Scruchet/Touch-Switch/control_card/control_card.kicad_pcb

## KiCad design control_card/control_card.kicad_pcb (2024-06-04)

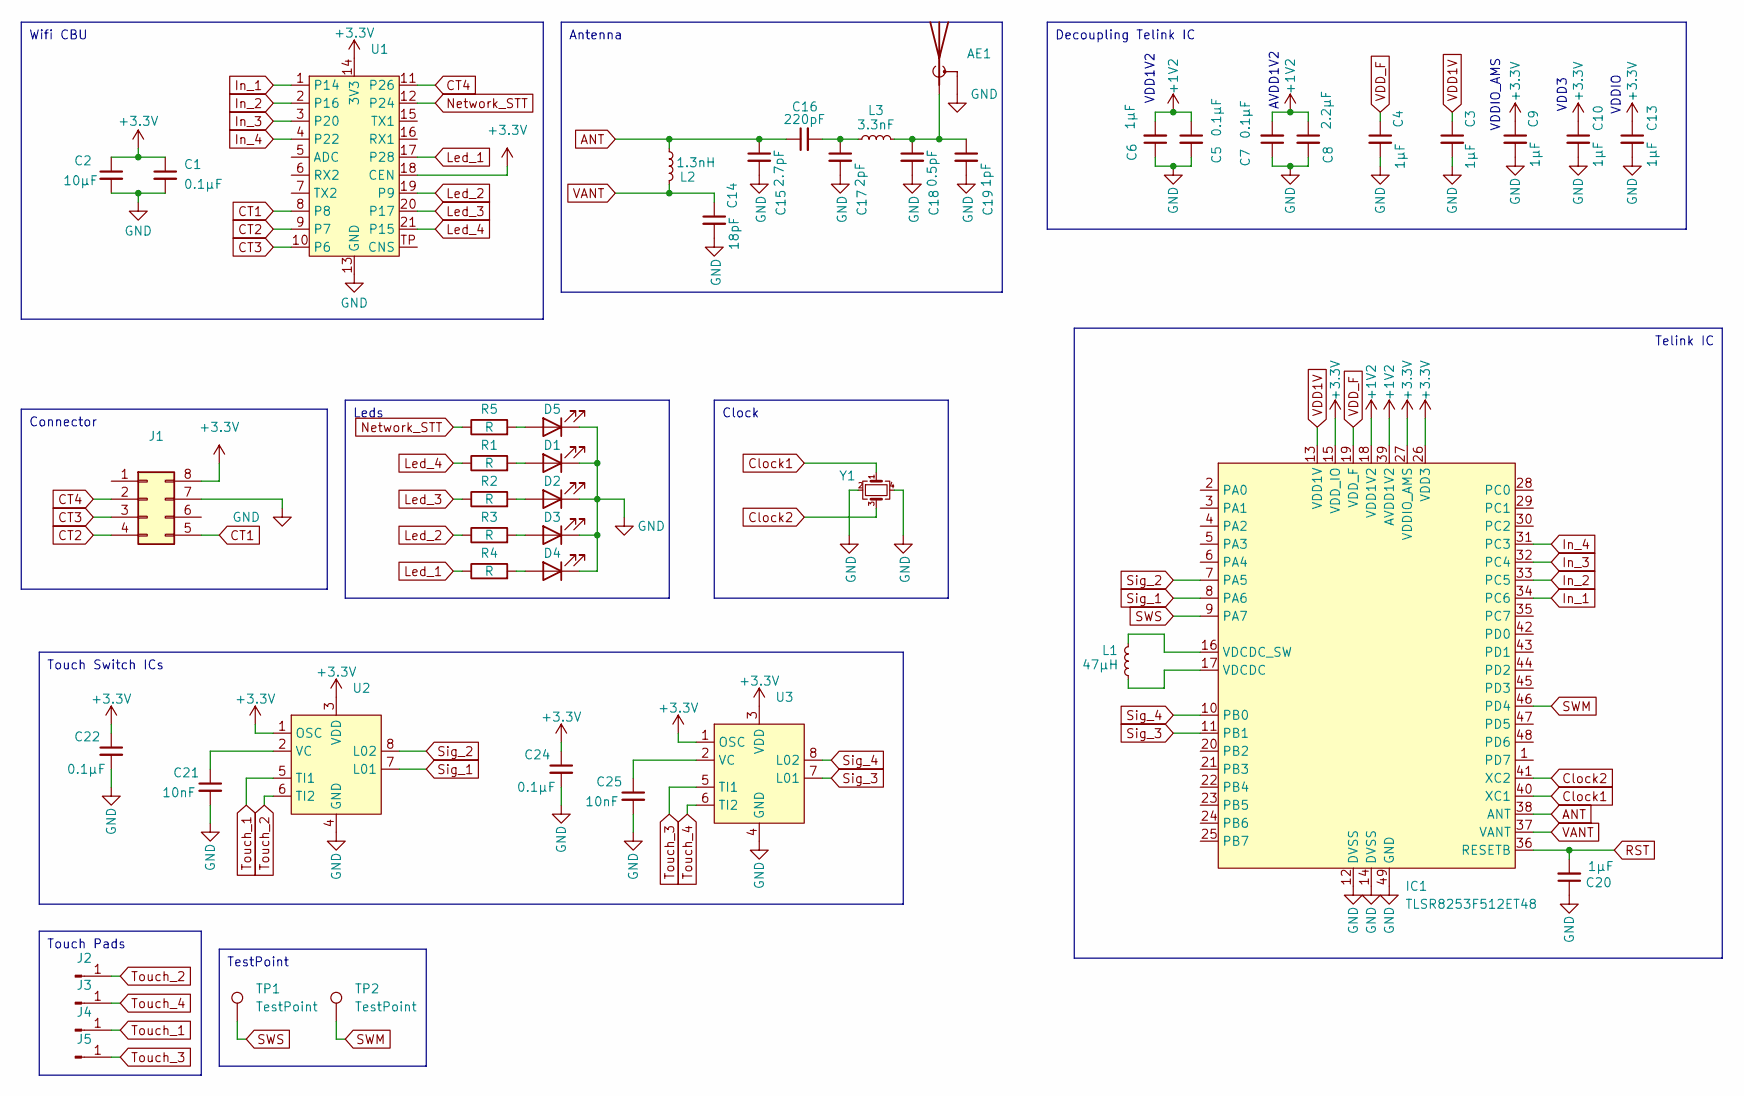
[picture p1: schematic control_card.kicad_sch]

Parts:
AE1: Antenna_Shield; Antenna
C1, C5, C7, C22, C24: 0.1µF; C_0603_1608Metric
C2: 10µF; C_0603_1608Metric
C3, C4, C6, C9, C10, C13, C20: 1µF; C_0603_1608Metric
C8: 2.2µF; C_0603_1608Metric
C14: 18pF; C_0603_1608Metric
C15: 2.7pF; C_0603_1608Metric
C16: 220pF; C_0603_1608Metric
C17: 2pF; C_0603_1608Metric
C18: 0.5pF; C_0603_1608Metric
C19: 1pF; C_0603_1608Metric
C21, C25: 10nF; C_0603_1608Metric
D1, D2, D3, D4, D5: LED; LED_0805_2012Metric
IC1: TLSR8253F512ET48; QFN-48-1EP_7x7mm_P0.5mm_EP5.6x5.6mm_ThermalVias; Mouser Part Number 141-TLSR8253F512ET32
J1: Conn_02x04_Counter_Clockwise; Male connector
J2, J3, J4, J5: Conn_01x01_Pin; Touch-Pad
L1: 47µH; L_0805_2012Metric
L2: 1.3nH; L_0402_1005Metric
L3: 3.3nF; L_0402_1005Metric
R1, R2, R3, R4, R5: R; R_0603_1608Metric
TP1, TP2: TestPoint; TestPoint_Pad_D1.0mm
U1: Wifi; Wifi CBU
U2, U3: SOIC-8_3.9x4.9mm_P1.27mm
Y1: Crystal_GND24_Small; Crystal_SMD_3225

Connections:
+1V2: C5.1, C6.2, C7.2, C8.1, IC1.18 (VDD1V2), IC1.39 (AVDD1V2)
+3.3V: C1.1, C2.1, C9.1, C10.1, C13.1, C22.1, C24.1, IC1.15 (VDD_IO), IC1.26 (VDD3), IC1.27 (VDDIO_AMS), J1.8, U1.14 (3V3), U1.18 (CEN), U2.1 (OSC), U2.3 (VDD), U3.1 (OSC), U3.3 (VDD)
ANT: C15.1, C16.1, IC1.38 (ANT), L2.1
CT1: J1.5, U1.8
CT2: J1.4, U1.9 (P7)
CT3: J1.3, U1.10 (P6)
CT4: J1.2, U1.11 (P26)
Clock1: IC1.40 (XC1), Y1.1
Clock2: IC1.41 (XC2), Y1.3
GND: AE1.2 (Shield), C1.2, C2.2, C3.2, C4.2, C5.2, C6.1, C7.1, C8.2, C9.2, C10.2, C13.2, C14.2, C15.2, C17.2, C18.2, C19.2, C20.1, C21.2, C22.2, C24.2, C25.2, D1.1 (K), D2.1 (K), D3.1 (K), D4.1 (K), D5.1 (K), IC1.12 (DVSS), IC1.14 (DVSS), IC1.49 (GND), J1.7, U1.13 (GND), U2.4 (GND), U3.4 (GND), Y1.2, Y1.4
In_1: IC1.34 (PC6), U1.1 (P14)
In_2: IC1.33 (PC5), U1.2 (P16)
In_3: IC1.32 (PC4), U1.3 (P20)
In_4: IC1.31 (PC3), U1.4 (P22)
Led_1: R4.1, U1.17 (P28)
Led_2: R3.1, U1.19 (P9)
Led_3: R2.1, U1.20 (P17)
Led_4: R1.1, U1.21 (P15)
unnamed: AE1.1 (A), C18.1, C19.1, L3.2
unnamed: C16.2, C17.1, L3.1
unnamed: D1.2 (A), R1.2
unnamed: D2.2 (A), R2.2
unnamed: D3.2 (A), R3.2
unnamed: D4.2 (A), R4.2
unnamed: D5.2 (A), R5.2
unnamed: IC1.17 (VDCDC), L1.1
unnamed: IC1.16 (VDCDC_SW), L1.2
unnamed: C21.1, U2.2 (VC)
unnamed: C25.1, U3.2 (VC)
Network_STT: R5.1, U1.12 (P24)
RST: C20.2, IC1.36 (RESETB)
SWM: IC1.46 (PD4), TP2.1; also elsewhere on the board
SWS: IC1.9 (PA7), TP1.1; also elsewhere on the board
Sig_1: IC1.8 (PA6), U2.7 (L01)
Sig_2: IC1.7 (PA5), U2.8 (L02)
Sig_3: IC1.11 (PB1), U3.7 (L01)
Sig_4: IC1.10 (PB0), U3.8 (L02)
Touch_1: J4.1, U2.5 (TI1)
Touch_2: J2.1, U2.6 (TI2)
Touch_3: J5.1, U3.5 (TI1)
Touch_4: J3.1, U3.6 (TI2)
VANT: C14.1, IC1.37 (VANT), L2.2
VDD1V: C3.1, IC1.13 (VDD1V)
VDD_F: C4.1, IC1.19 (VDD_F)

Notes on the sheet:
TestPoint
Antenna
Touch Switch ICs
Touch Pads
Leds
Wifi CBU
Connector
Clock
Decoupling Telink IC
Telink IC
AVDD1V2
VDD1V2
VDDIO
VDD3
VDDIO_AMS

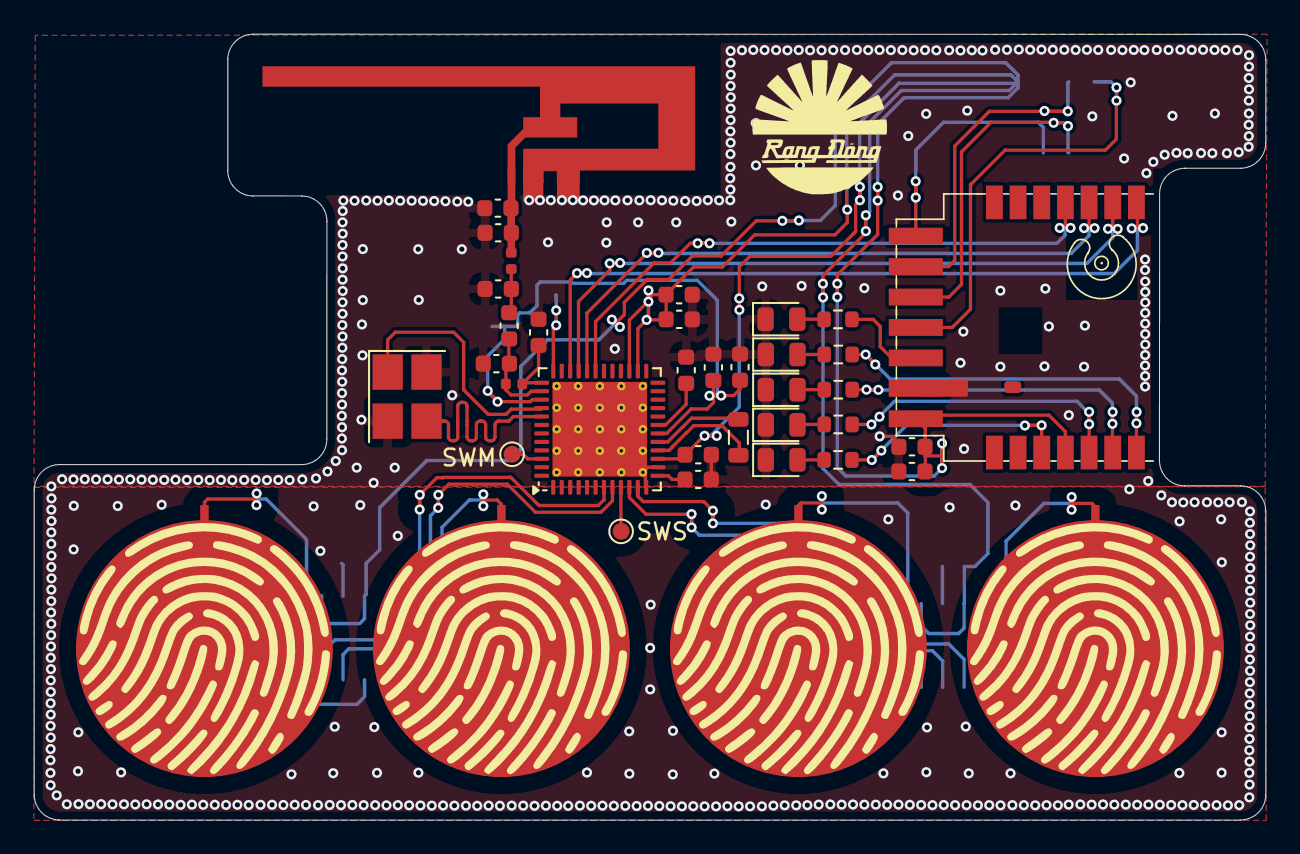
[picture p2: board control_card.kicad_pcb from above]

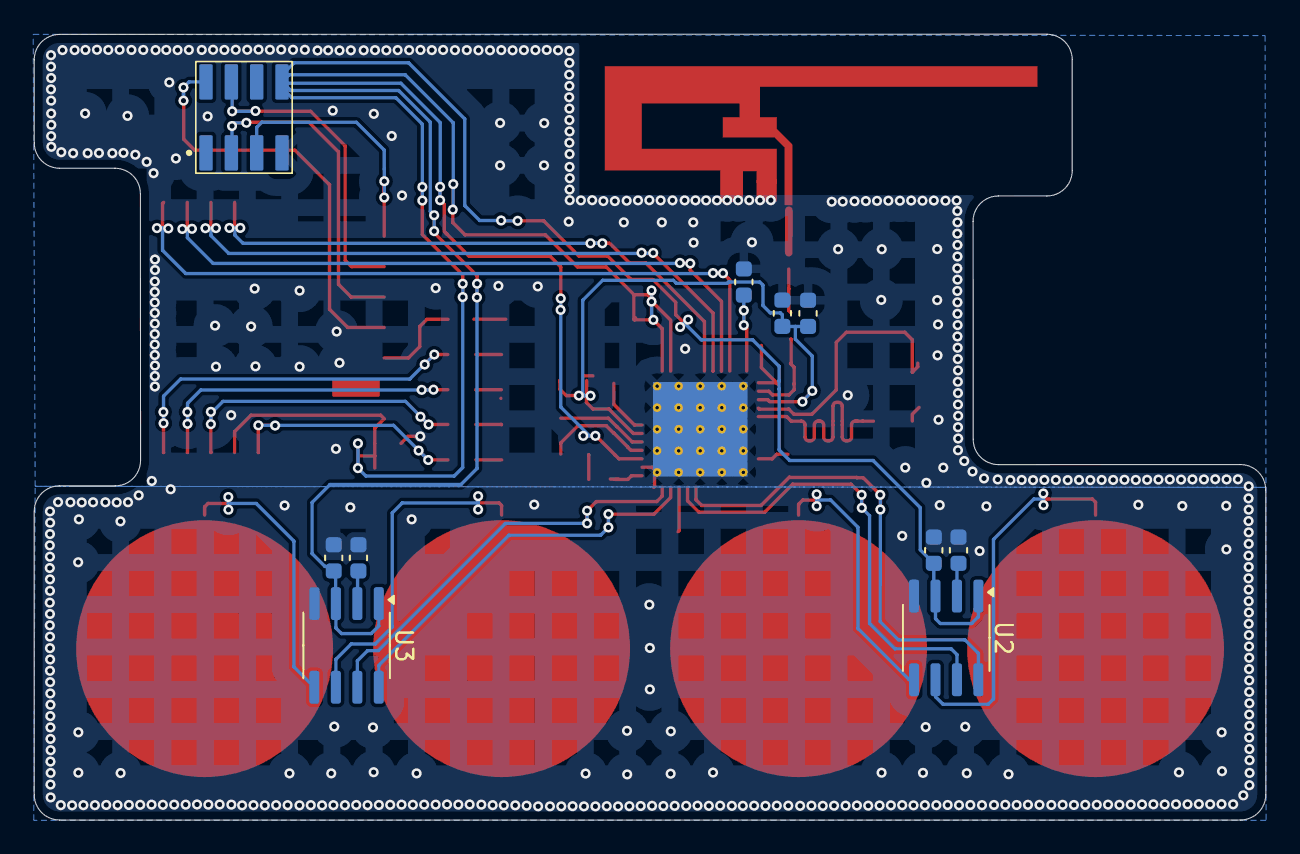
[picture p3: board control_card.kicad_pcb from below]

Board: 2 copper layers, 72.9 x 46.5 mm, 48 parts (10 on the bottom side), 44 nets.

Other parts of the board:
SWM: TestPoint; TestPoint_Pad_D1.0mm
SWS: TestPoint; TestPoint_Pad_D1.0mm

Their connections:
SWM: SWM.1; also elsewhere on the board
SWS: SWS.1; also elsewhere on the board
