Scruchet/Touch-Switch/power_supply/Touch Switch.kicad_pcb

## KiCad design power_supply/Touch Switch.kicad_pcb (2024-05-30)

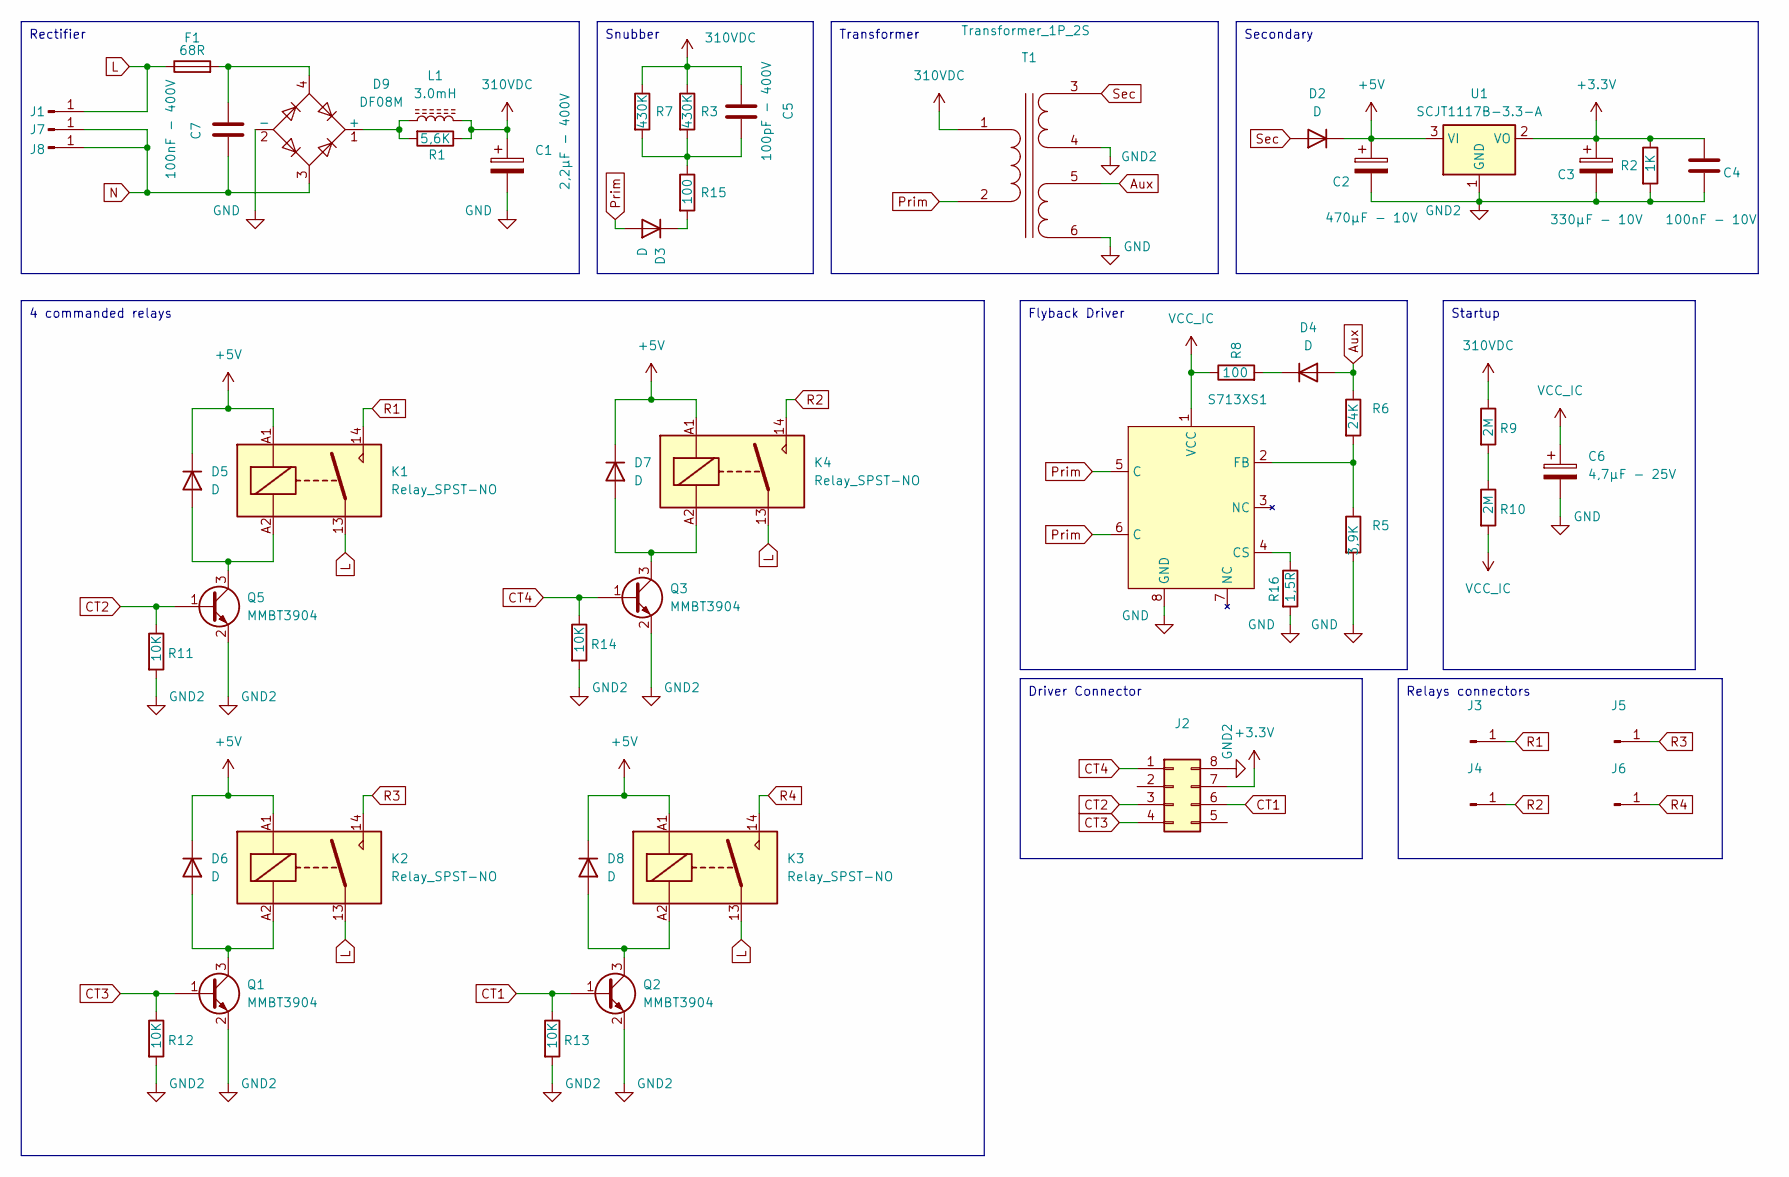
[picture p4: schematic Touch Switch.kicad_sch]

Parts:
C1: 2,2µF - 400V; CP_Radial_D8.0mm_P3.50mm
C2: 470µF - 10V; CP_Radial_D6.3mm_P2.50mm
C3: 330µF - 10V; CP_Radial_D6.3mm_P2.50mm
C4: 100nF - 10V; C_0805_2012Metric
C5: 100pF - 400V; C_1206_3216Metric
C6: 4,7µF - 25V; C_0805_2012Metric
C7: 100nF - 400V; MKP-X2-100NR10310
D2, D3, D4: D; D_SMA
D5, D6, D7, D8: D; D_SOD-123
D9: DF08M; Diode_Bridge_Diotec_ABS
F1: 68R; fuse
J1, J3, J4, J5, J6, J7, J8: Conn_01x01_Pin; power_connector
J2: Conn_02x04_Counter_Clockwise; Female connector
K1, K2, K3, K4: Relay_SPST-NO; relay
L1: 3.0mH; L_Radial_D7.5mm_P3.50mm_Fastron_07P
Q1, Q2, Q3, Q5: MMBT3904; SOT-23
R1: 5,6K; R_0805_2012Metric
R2: 1K; R_1206_3216Metric
R3, R7: 430K; R_1206_3216Metric
R5: 3,9K; R_0805_2012Metric
R6: 24K; R_0805_2012Metric
R8: 100; R_0805_2012Metric
R9, R10: 2M; R_1206_3216Metric
R11, R12, R13, R14: 10K; R_0805_2012Metric
R15: 100; R_1206_3216Metric
R16: 1,5R; R_1206_3216Metric
S713XS1: SOP-8_3.9x4.9mm_P1.27mm
T1: Transformer_1P_2S; transformer
U1: SCJT1117B-3.3-A; SOT-223-3_TabPin2

Connections:
310VDC: C1.1, C5.1, L1.2, R1.1, R3.1, R7.1, R9.1, T1.1 (AA)
+3.3V: C3.1, C4.1, J2.7, R2.1, U1.2 (VO)
+5V: C2.1, D2.1 (K), D5.1 (K), D6.1 (K), D7.1 (K), D8.1 (K), K1.A1, K2.A1, K3.A1, K4.A1, U1.3 (VI)
Aux: D4.2 (A), R6.1, T1.5 (SC)
CT1: J2.6, Q2.1 (B), R13.1
CT2: J2.3, Q5.1 (B), R11.1
CT3: J2.4, Q1.1 (B), R12.1
CT4: J2.1, Q3.1 (B), R14.1
GND: C1.2, C6.2, D9.2 (-), R5.2, R16.2, S713XS1.8 (GND), T1.6 (SD)
GND2: C2.2, C3.2, C4.2, J2.8, Q1.2 (E), Q2.2 (E), Q3.2 (E), Q5.2 (E), R2.2, R11.2, R12.2, R13.2, R14.2, T1.4 (SB), U1.1 (GND)
L: F1.1, J1.1, K1.13, K2.13, K3.13, K4.13
N: C7.2, D9.3, J7.1, J8.1
unnamed: C5.2, R3.2, R7.2, R15.1
unnamed: C7.1, D9.4, F1.2
unnamed: D3.1 (K), R15.2
unnamed: D4.1 (K), R8.2
unnamed: D5.2 (A), K1.A2, Q5.3 (C)
unnamed: D6.2 (A), K2.A2, Q1.3 (C)
unnamed: D7.2 (A), K4.A2, Q3.3 (C)
unnamed: D8.2 (A), K3.A2, Q2.3 (C)
unnamed: D9.1 (+), L1.1, R1.2
unnamed: R9.2, R10.1
unnamed: R16.1, S713XS1.4 (CS)
unnamed: R5.1, R6.2, S713XS1.2 (FB)
Prim: D3.2 (A), S713XS1.5 (C), S713XS1.6 (C), T1.2 (AB)
R1: J3.1, K1.14
R2: J4.1, K4.14
R3: J5.1, K2.14
R4: J6.1, K3.14
Sec: D2.2 (A), T1.3 (SA)
VCC_IC: C6.1, R8.1, R10.2, S713XS1.1 (VCC)

Notes on the sheet:
Transformer
Snubber
Startup
4 commanded relays
Relays connectors
Driver Connector
Rectifier
Secondary
Flyback Driver

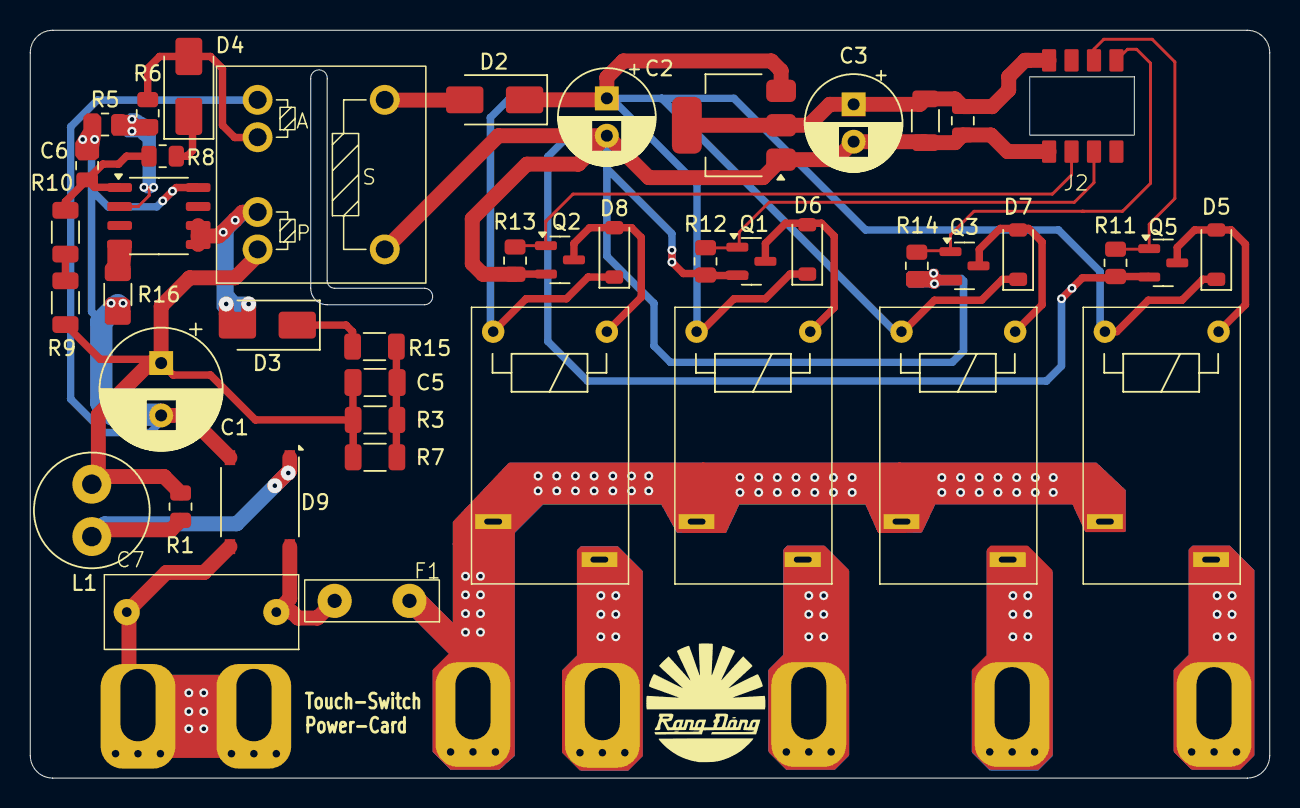
[picture p5: board Touch Switch.kicad_pcb from above]

Board: 2 copper layers, 82.9 x 50.0 mm, 51 parts (0 on the bottom side), 31 nets.
