Scruchet/Touch-Switch/(commit log)

2024-05-17 Schematic finished
    [Touch Switch.kicad_sch, relay.kicad_sch]
2024-05-17 PCB started
    [Touch Switch.kicad_pcb, Touch Switch.kicad_sch, relay.kicad_sch]
2024-05-20 PCB V1
    [Touch Switch.kicad_pcb, Touch Switch.kicad_sch]
2024-05-20 PCB V2
    [Touch Switch.kicad_pcb, Touch Switch.kicad_sch]
2024-05-20 End 20-05-2024
    [Touch Switch.kicad_pcb, Touch Switch.kicad_sch]
2024-05-21 Secondary without GND PLANE
    [Touch Switch.kicad_pcb, Touch Switch.kicad_sch]
2024-05-23 PCB V3
    [Touch Switch.kicad_pcb, Touch Switch.kicad_sch]
2024-05-23 Reorganizing files in the project folder
    [Touch Switch.kicad_pcb, Touch Switch.kicad_sch]
2024-05-24 Modification : PCB
    [Touch Switch.kicad_pcb]
2024-05-24 Modified : PCB
    [Touch Switch.kicad_pcb]
2024-05-27 New Kicad Project + tree modified
    [Touch Switch.kicad_pcb, control_card.kicad_pcb, control_card.kicad_sch]
2024-05-27 Control Card Started : Schematic & PCB
    [control_card.kicad_pcb, control_card.kicad_sch]
2024-05-28 PCB : started footprint and rooting
    [control_card.kicad_pcb, control_card.kicad_sch]
2024-05-28 PCB (control_card): Almost Finished
    [Touch Switch.kicad_pcb, control_card.kicad_pcb, control_card.kicad_sch]
2024-05-29 PCB (control_card) : V1 finished
    [control_card.kicad_pcb]
2024-05-29 PCB (control_card): V2 almost finished
    [Touch Switch.kicad_pcb, control_card.kicad_pcb, control_card.kicad_sch]
2024-05-30 PCB (control_card) : V3 finished, perfect dimension
    [Touch Switch.kicad_pcb, Touch Switch.kicad_sch, control_card.kicad_pcb, control_card.kicad_sch]
2024-05-30 PCB (control_card): ready for review
    [control_card.kicad_pcb]
2024-05-31 PCB (control_card) : modified
    [control_card.kicad_pcb]
2024-06-04 PCB (control_card) : Test point added
    [control_card.kicad_pcb, control_card.kicad_sch]
2024-06-04 PCB (control_card): modified
    [control_card.kicad_pcb]
